StaznikSystems/Rocket-Beacon/hardware/documentation/Schematic.pdf

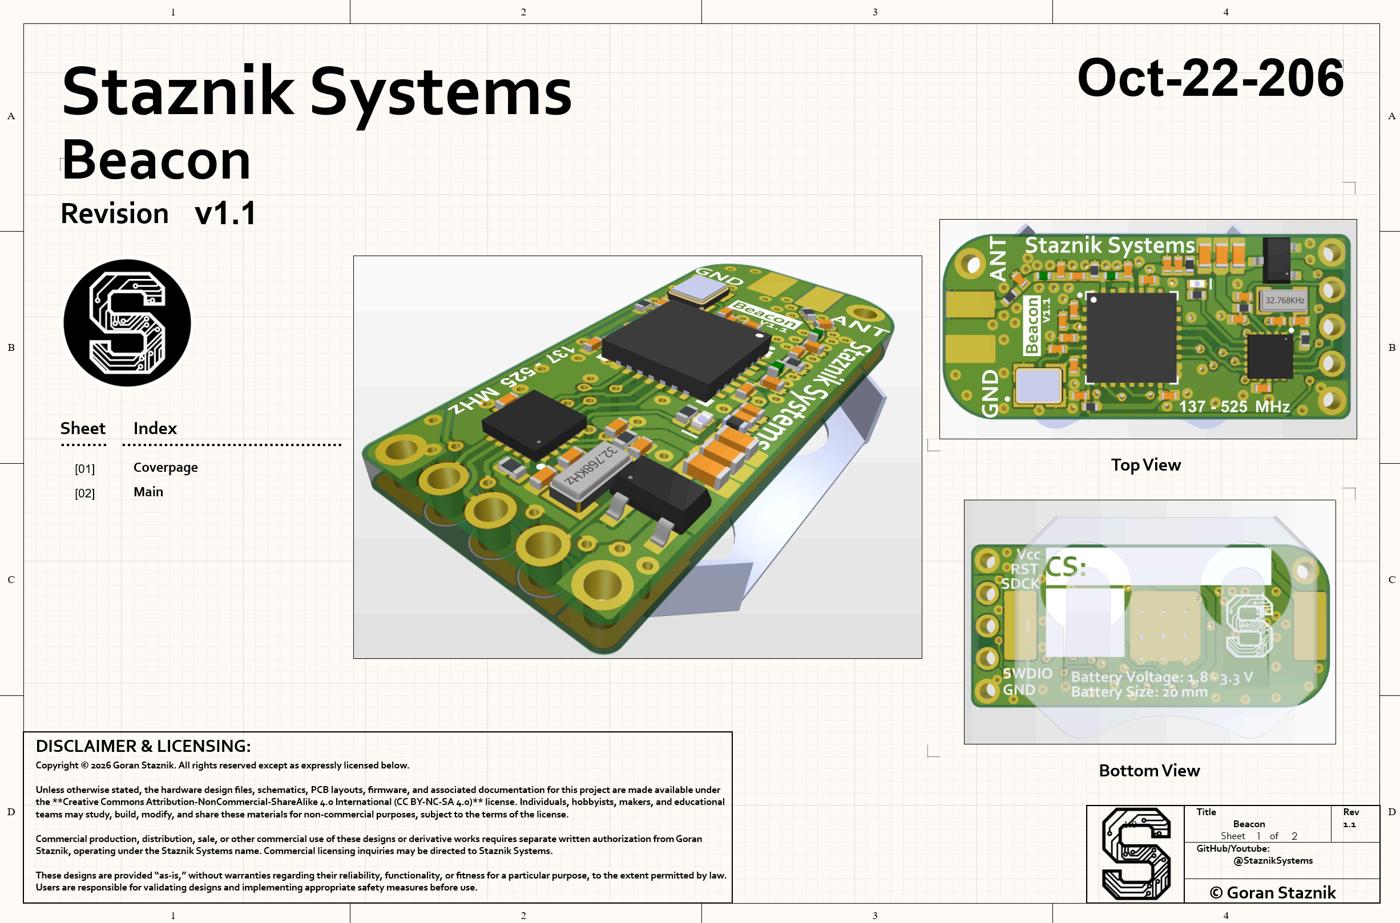
[picture p4: page 1]
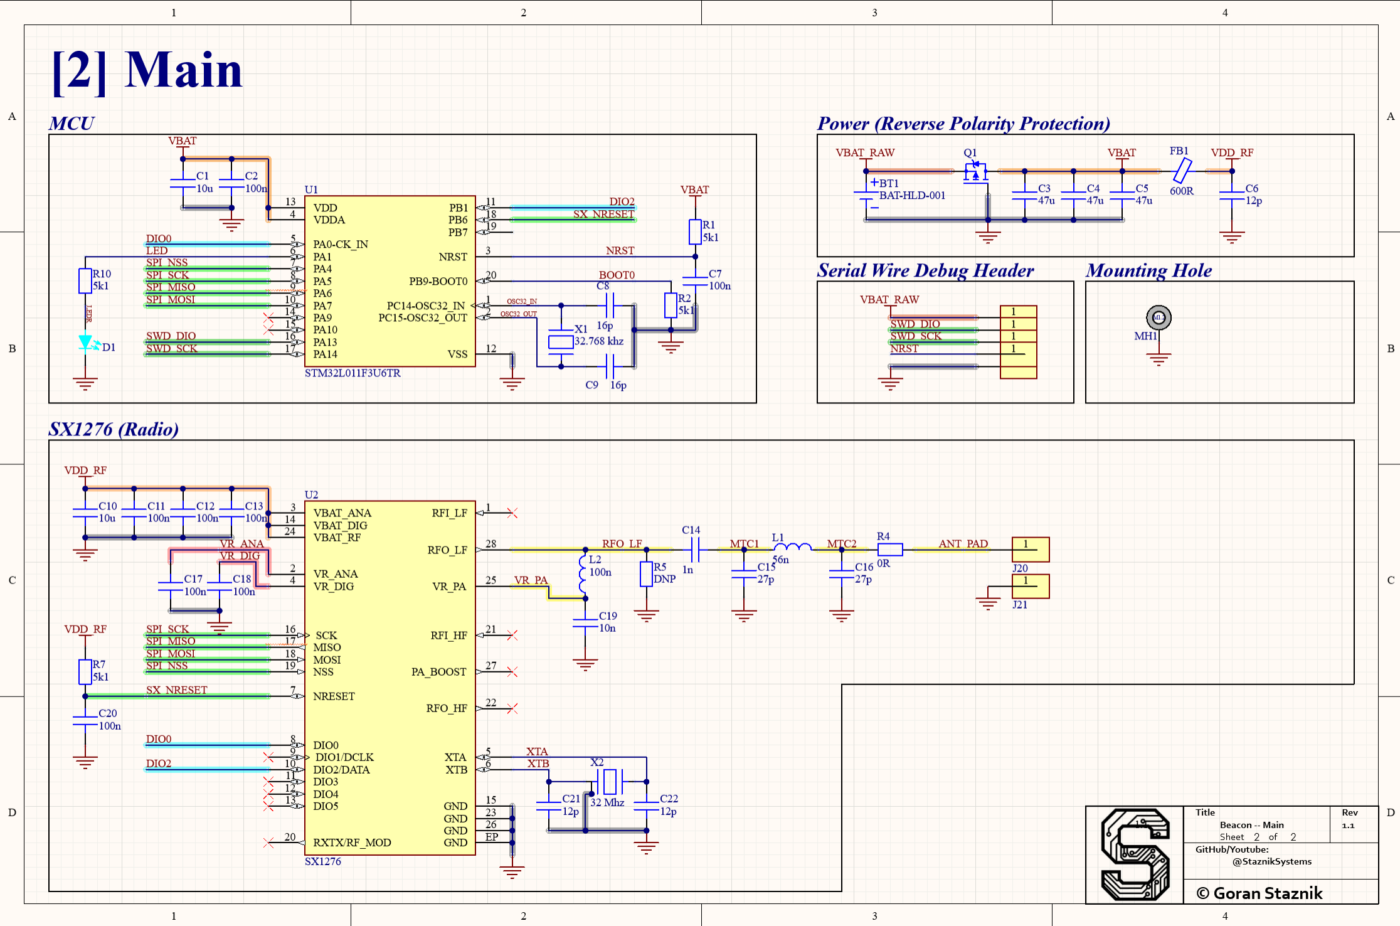
[picture p5: page 2]
