StaznikSystems/Rocket-Beacon/hardware/BOM/BOM.xlsx

Notes | Designator | Name | Description | Package | Status | Quantity | Manufacturer | Manufacturer Part Number | Supplier | Supplier Part Number | Supplier Unit Price (CAD) | Subtotal (CAD)
DNP | BT1 | BAT-HLD-001 | Battery Retainer Coin, 20.0mm 1 Cell SMD (SMT) Tab | NS | Active | 1 | TE Connectivity | BAT-HLD-001 | Digikey | BAT-HLD-001-ND | $0.3800 | $0.3800
Populate | C1, C10 | 10u | 0402 Capacitor | 0402 | Not Sourced | 2
Populate | C2, C7, C11, C12, C13, C17, C18, C20, | 100n | 0402 Capacitor | 0402 | Not Sourced | 8
Populate | C3, C4, C5 | 47u | 0603 Capacitor | 0603 | Not Sourced | 3
Populate | C6, C21, C22 | 12p | 0402 Capacitor | 0402 | Not Sourced | 3
Populate | C8, C9 | 16p | 0402 Capacitor | 0402 | Not Sourced | 2
Populate | C14 | 1n | 0402 Capacitor | 0402 | Not Sourced | 1
Populate | C15, C16 | 27p | 0402 Capacitor | 0402 | Not Sourced | 2 | Murata | GJM1555C1H270FB01J | Digikey |  | $0.0709 | $0.1418
Populate | C19 | 10n | 0402 Capacitor | 0402 | Not Sourced | 1
Populate | D1 | LED_0402_B | 0402 Blue LED | 0402 | Not Sourced | 1
Populate | FB1 | 600R | 0402 Ferrite Bead | 0402 | Not Sourced | 1 | Murata | BLM15AX601SN1D | Digikey |  | $0.0139 | $0.0139
Populate | L1 | 56n | 0402 Inductor | 0402 | Not Sourced | 1 | Murata | LQW15AN56NH00D | Digikey |  | $1.0200 | $1.0200
Populate | L2 | 100n | 0402 Inductor | 0402 | Not Sourced | 1 | Murata | LQW18ANR10G80D | Digikey |  | $0.1221 | $0.1221
Populate | Q1 | P-TYPE_SOT23 | SOT23 P-TYPE MOSFET | SOT23 | Active | 1 | Alpha & Omega Semiconductor | AO3401A | Digikey | 785-1001-2-ND | $0.5200 | $0.5200
DNP | MH1
DNP | J21,J2,J20,J3,J4,J5,J6
Populate | R1, R2, R7, R10 | 5k1 | 0402 Resistor | 0402 | Active | 4 | Yageo Group | AC0402FR-7W5K1L | Digikey |  | $0.0077 | $0.0308
Populate | R4 | 0R | 0402 Resistor | 0402 | Not Sourced | 1
DNP | R5 | DNP | 0402 Resistor | 0402 | DNP | 1
Populate | U1 | STM32L011F3U6TR | ARM Cortex-M0+ STM32L0 Microcontroller IC 32-Bit 32MHz 8KB (8K x 8) FLASH 20-UFQFPN (3x3) | UFQFPN-20 | Active | 1 | STMicroelectronics | STM32L011F3U6TR | Digikey |  | $7.3000 | $7.3000
Populate | U2 | SX1276 | IC RF TxRx Only 802.15.4 LoRa 137MHz ~ 1.02GHz 28-VQFN Exposed Pad | VQFN-28 | Active | 1 | Semtech | SX1276IMLTRT | Digikey |  | $11.4400 | $11.4400
Populate | X1 | 32.768 kHz | 32.768kHz Crystal, 12.5 pF Load | NS | Active | 1 | Jauch | Q 0,032768-JTX310-12,5-20-T2-70K-LF | Digikey |  | $0.2700 | $0.2700
Populate | X2 | 32 MHz | 32 MHz Crystal, 8pF Load | NS | Active | 1 | Jauch | J32SMX-K-F-D-I-32M0 | Digikey |  | $0.3000 | $0.3000
 |  |  |  |  |  |  |  |  |  |  | Total | $21.5386
