StaznikSystems/Rocket-Beacon/hardware/3dModel/Beacon.step

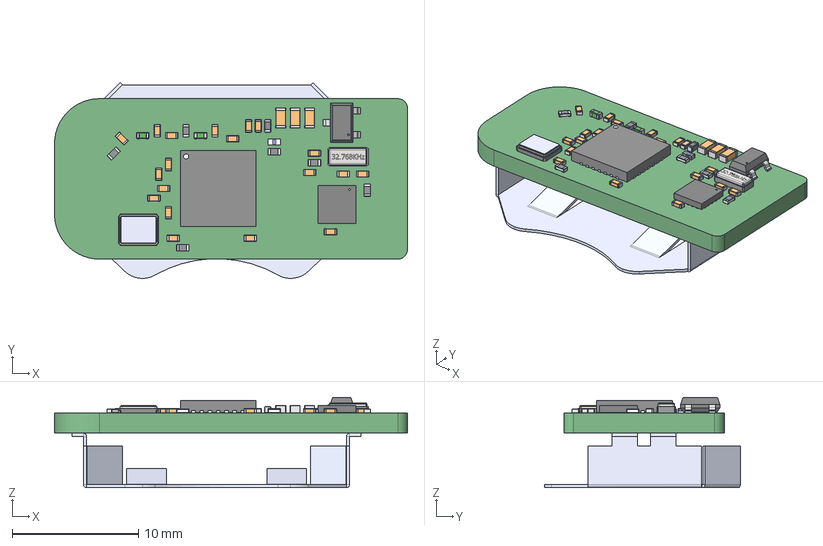
[picture p6: CAD file, 2026-10-23]
hardware/3dModel/Beacon.step
27.9 x 15.5 x 7.16 mm
R0402 AC0402 x 24
0402 Blue x 6
NX3225SA-32MHZ-EXS00A-CS02368
Crystal_3215
Pin1 x 2
Pin2 x 2
CeramicBody x 2
ferrite_bead_0402
C0402_035 x 57
C0603_060 x 9
BAT-HLD-001
