StaznikSystems/Rocket-Beacon/hardware/documentation/BeaconAssemDoc.pdf

A

B

C

D

E

1 | 1

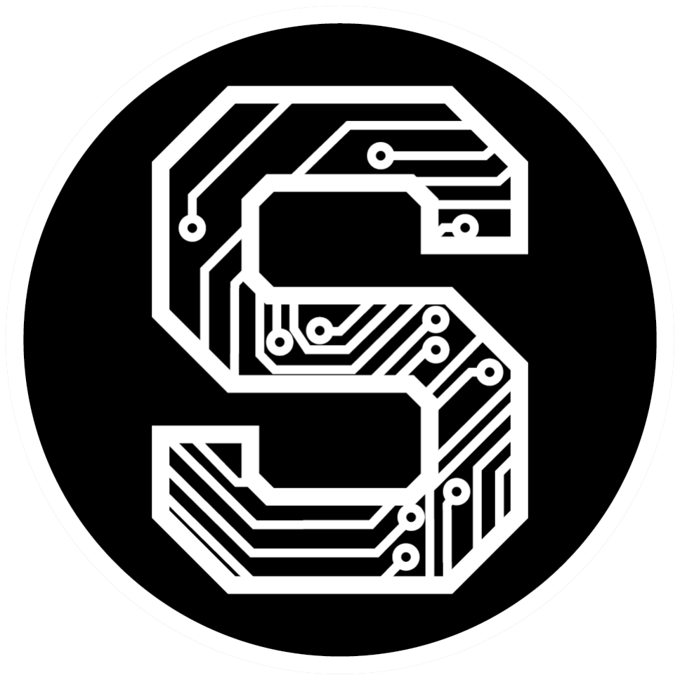
[picture p7: figure]

2 | 2

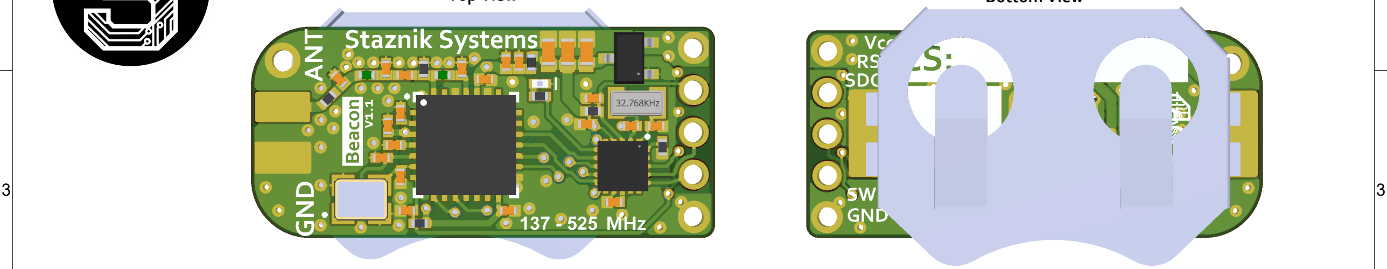
[picture p8: figure]
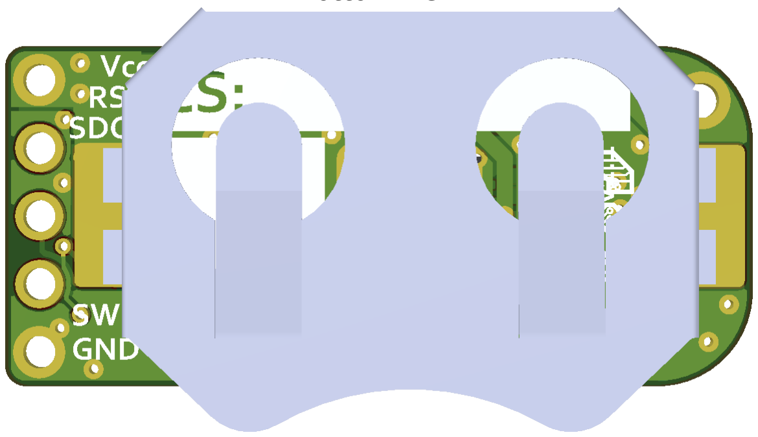
[picture p9: figure]

4 | 4

### Title Sheet 1 of 5

# © Goran Staznik

### Rev

### GitHub/YouTube: @StaznikSystems

Cover Page | 1.1

Copyright © Goran Staznik. All rights reserved except as expressly licensed below.

Unless otherwise stated, the hardware design files, schematics, PCB layouts, firmware, and associated documentation for this project are made available under the **Creative Commons Attribution-NonCommercial-ShareAlike 4.0 International (CC BY-NC-SA 4.0)** license. Individuals, hobbyists, makers, and educational teams may study, build, modify, and share these materials for non-commercial purposes, subject to the terms of the license.

Commercial production, distribution, sale, or other commercial use of these designs or derivative works requires separate written authorization from Goran Staznik, operating under the Staznik Systems name. Commercial licensing inquiries may be directed to Staznik Systems.

These designs are provided “as-is,” without warranties regarding their reliability, functionality, or fitness for a particular purpose, to the extent permitted by law. Users are responsible for validating designs and implementing appropriate safety measures before use.

# DISCLAIMER & LICENSING

# Beacon

# Staznik Systems

# Revision

# Assembly Documentation

Top View | Bottom View

v1.1

1 | 1

# [2] Isometric Views

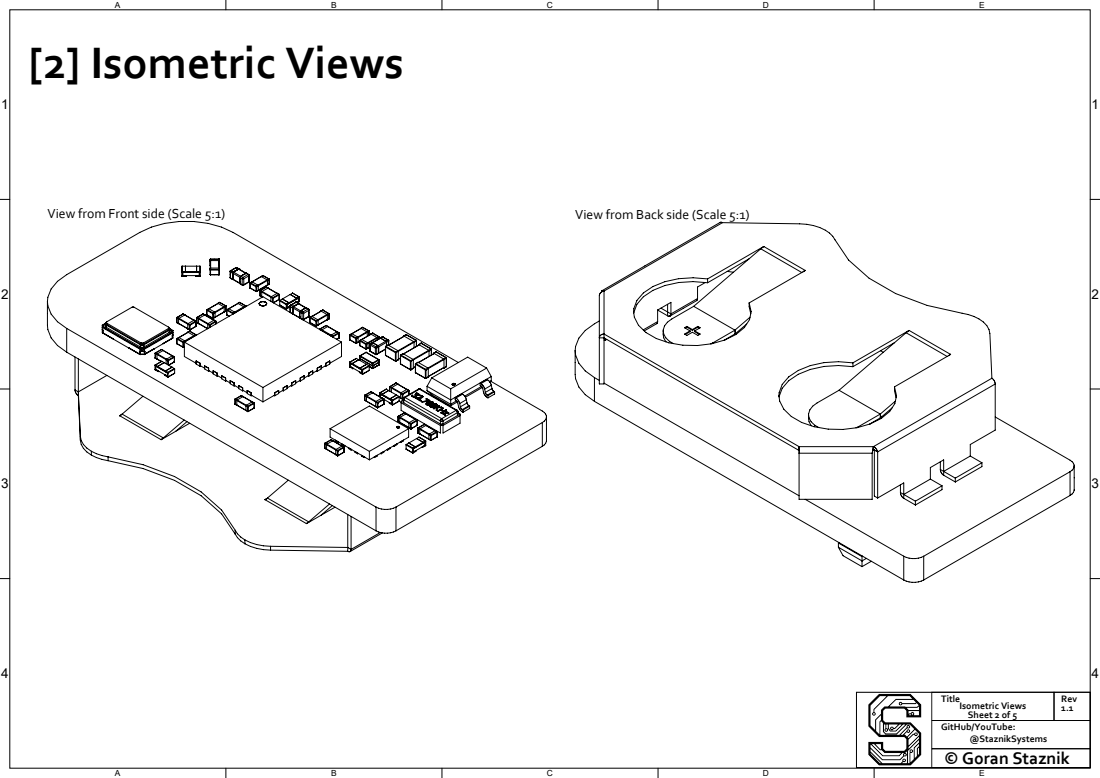
[picture p10: page 2]
View from Front side (Scale 5:1); View from Back side (Scale 5:1); Title; Sheet 2 of 5; Rev; Isometric Views

1 | 1

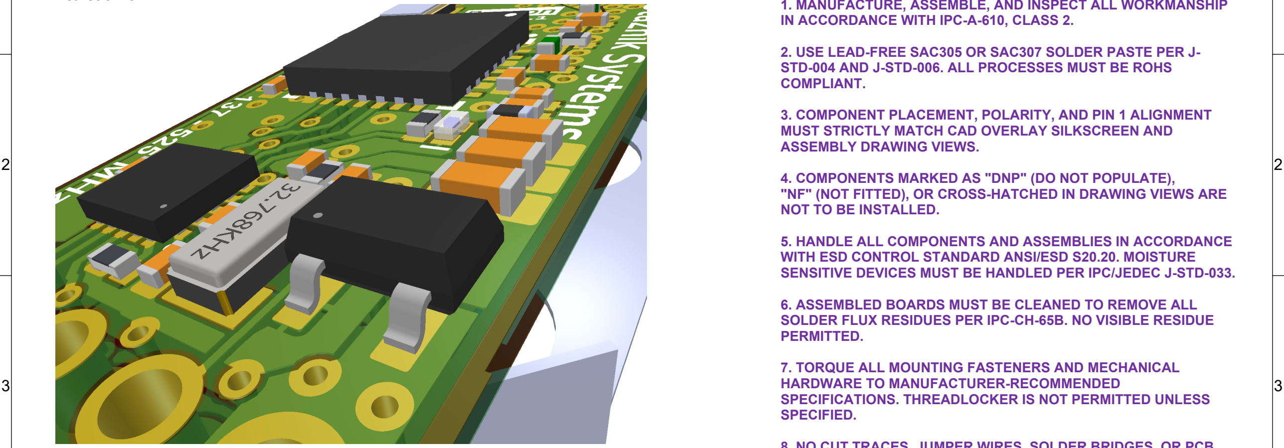
[picture p11: figure]
IN ACCORDANCE WITH IPC-A-610, CLASS 2.; COMPLIANT.; ASSEMBLY DRAWING VIEWS.; NOT TO BE INSTALLED.; PERMITTED.; HARDWARE TO MANUFACTURER-RECOMMENDED; SPECIFIED.

4 | 4

# [3] Notes

NOTES: UNLESS OTHERWISE SPECIFIED.

## 1. MANUFACTURE, ASSEMBLE, AND INSPECT ALL WORKMANSHIP

## 2. USE LEAD-FREE SAC305 OR SAC307 SOLDER PASTE PER J-STD-004 AND J-STD-006. ALL PROCESSES MUST BE ROHS

## 3. COMPONENT PLACEMENT, POLARITY, AND PIN 1 ALIGNMENT MUST STRICTLY MATCH CAD OVERLAY SILKSCREEN AND

4. COMPONENTS MARKED AS "DNP" (DO NOT POPULATE),

## "NF" (NOT FITTED), OR CROSS-HATCHED IN DRAWING VIEWS ARE

## 5. HANDLE ALL COMPONENTS AND ASSEMBLIES IN ACCORDANCE WITH ESD CONTROL STANDARD ANSI/ESD S20.20. MOISTURE

SENSITIVE DEVICES MUST BE HANDLED PER IPC/JEDEC J-STD-033.

## 6. ASSEMBLED BOARDS MUST BE CLEANED TO REMOVE ALL SOLDER FLUX RESIDUES PER IPC-CH-65B. NO VISIBLE RESIDUE

## 7. TORQUE ALL MOUNTING FASTENERS AND MECHANICAL

## SPECIFICATIONS. THREADLOCKER IS NOT PERMITTED UNLESS

## 8. NO CUT TRACES, JUMPER WIRES, SOLDER BRIDGES, OR PCB MODIFICATIONS ARE PERMITTED WITHOUT PRIOR WRITTEN

AUTHORIZATION.

# Realistic View

### Title Sheet 3 of 5

### Rev

Notes | 1.1

1 | 1

# View from Top side (Scale 8:1)

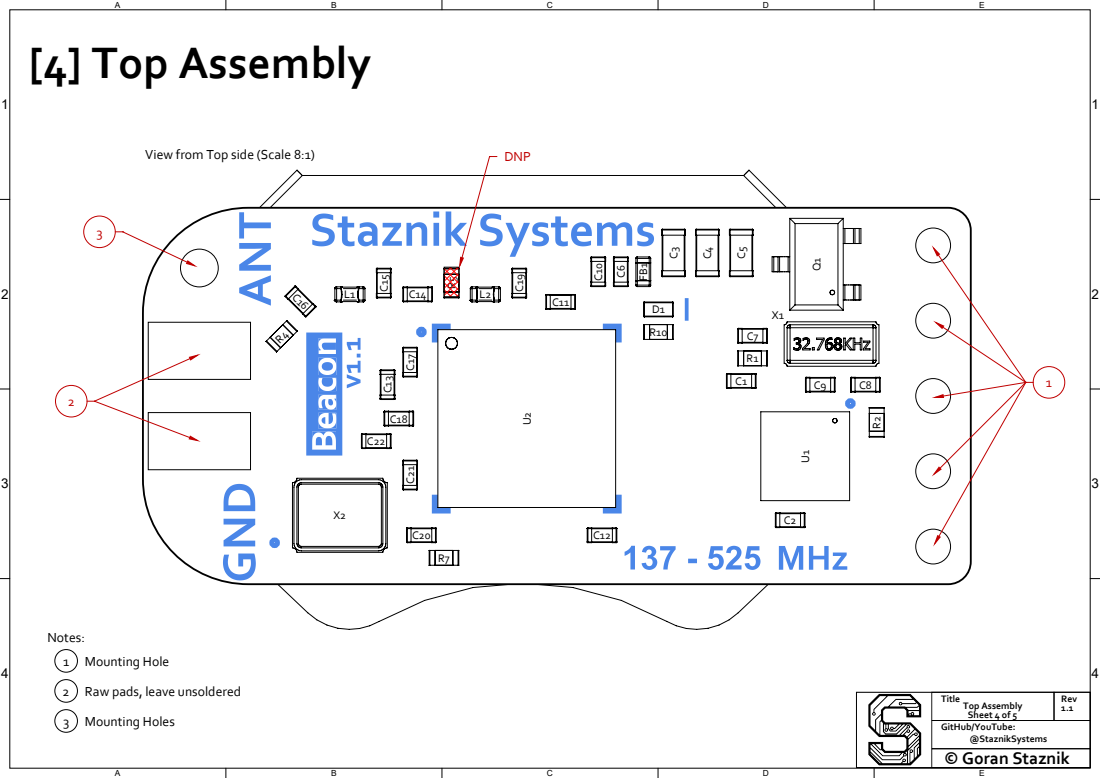
[picture p12: page 4]

Notes:
1 Mounting Hole
2 Raw pads, leave unsoldered
3 Mounting Holes

1 | 1

# View from Bottom side (Scale 8:1)

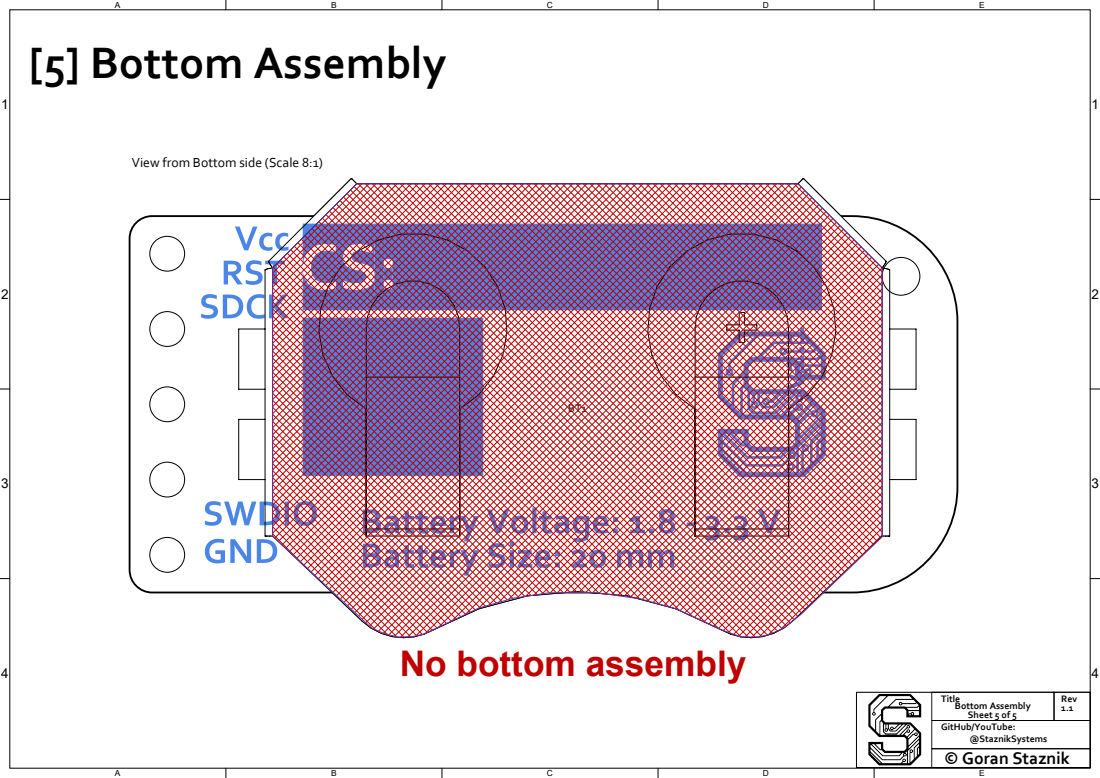
[picture p13: page 5]
[5] Bottom Assembly; Title; Sheet 5 of 5; Rev; Bottom Assembly

No bottom assembly
