StaznikSystems/Rocket-Beacon/hardware/documentation/BeaconFabDoc.pdf

A

B

C

D

E

1 | 1

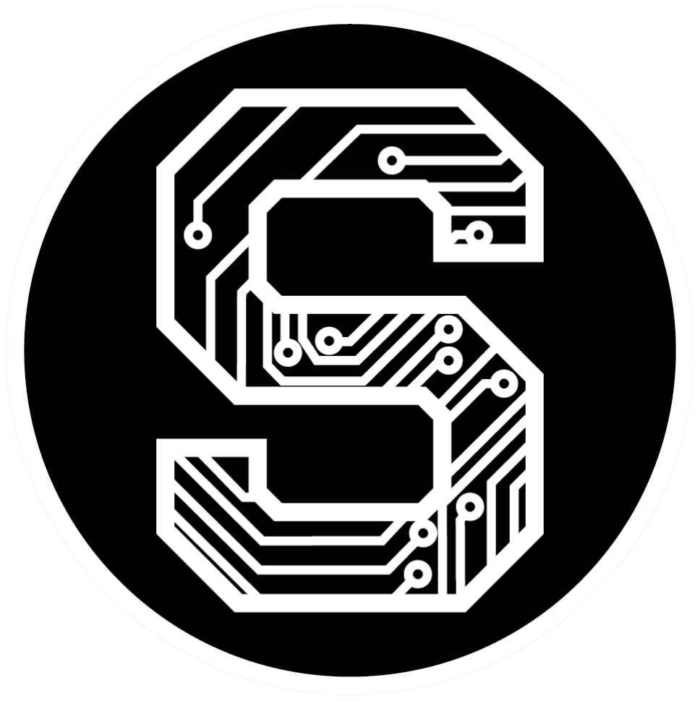
[picture p14: figure]

2 | 2

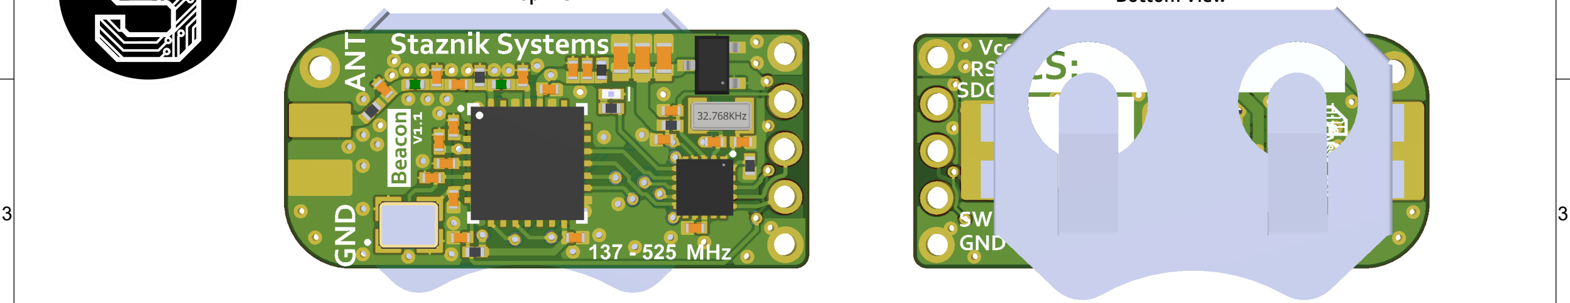
[picture p15: figure]
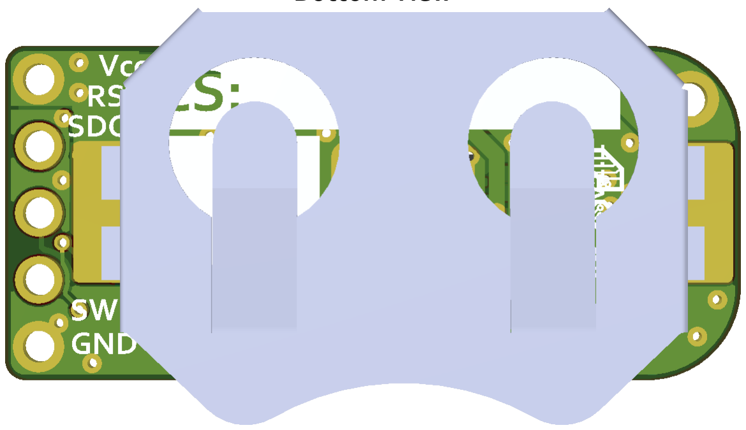
[picture p16: figure]

4 | 4

# Beacon

# Staznik Systems

# Revision

# PCB Fabrication Documentation

Title
Sheet 1 of 4
Top View | Bottom View

## © Goran Staznik

Rev

GitHub/YouTube:
@StaznikSystems

Copyright © Goran Staznik. All rights reserved except as expressly licensed below.

Unless otherwise stated, the hardware design files, schematics, PCB layouts, firmware, and associated documentation for this project are made available under the **Creative Commons Attribution-NonCommercial-ShareAlike 4.0 International (CC BY-NC-SA 4.0)** license. Individuals, hobbyists, makers, and educational teams may study, build, modify, and share these materials for non-commercial purposes, subject to the terms of the license.

Commercial production, distribution, sale, or other commercial use of these designs or derivative works requires separate written authorization from Goran Staznik, operating under the Staznik Systems name. Commercial licensing inquiries may be directed to Staznik Systems.

These designs are provided “as-is,” without warranties regarding their reliability, functionality, or fitness for a particular purpose, to the extent permitted by law. Users are responsible for validating designs and implementing appropriate safety measures before use.

## DISCLAIMER & LICENSING

v1.1

Cover Page | 1.1

# [2] Stack up & Impedance Information

Material | Layer | Thickness Dielectric Material Type | Gerber

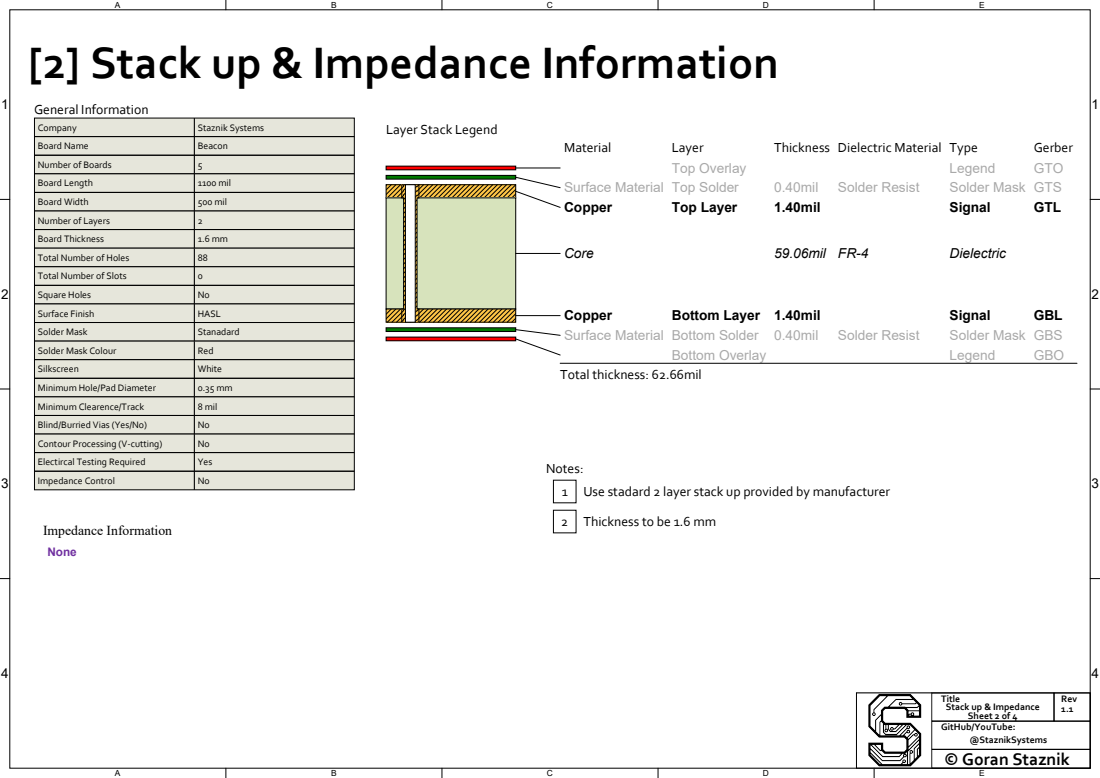
[picture p17: page 2]
Top Overlay; Legend; GTO; Surface Material Top Solder; 0.40mil; Solder Resist; Solder Mask GTS; Copper; Top Layer; 1.40mil; Signal; GTL; Core; 59.06mil FR-4; Dielectric; Bottom Layer 1.40mil; GBL; Surface Material Bottom Solder 0.40mil; Solder Mask GBS; Bottom Overlay; GBO; Total thickness: 62.66mil; Company; Layer Stack Legend; Staznik Systems; Beacon; 1100 mil; 500 mil; HASL; Stanadard; Red; White; 8 mil; Yes; Impedance Information; None; Title; Sheet 2 of 4; Rev; Stack up & Impedance

General Information
Board Name
Number of Boards
Board Length
Board Width
Number of Layers
Board Thickness
Total Number of Holes
Total Number of Slots

Square Holes
Surface Finish
Solder Mask
Solder Mask Colour
Silkscreen
Minimum Hole/Pad Diameter
Minimum Clearence/Track
Blind/Burried Vias (Yes/No)
Contour Processing (V-cutting)
Electircal Testing Required
Impedance Control

Notes:
1 Use stadard 2 layer stack up provided by manufacturer
2 Thickness to be 1.6 mm

### Drill Drawing View (Scale 5:1)

# [3] Drill Drawing & Notes

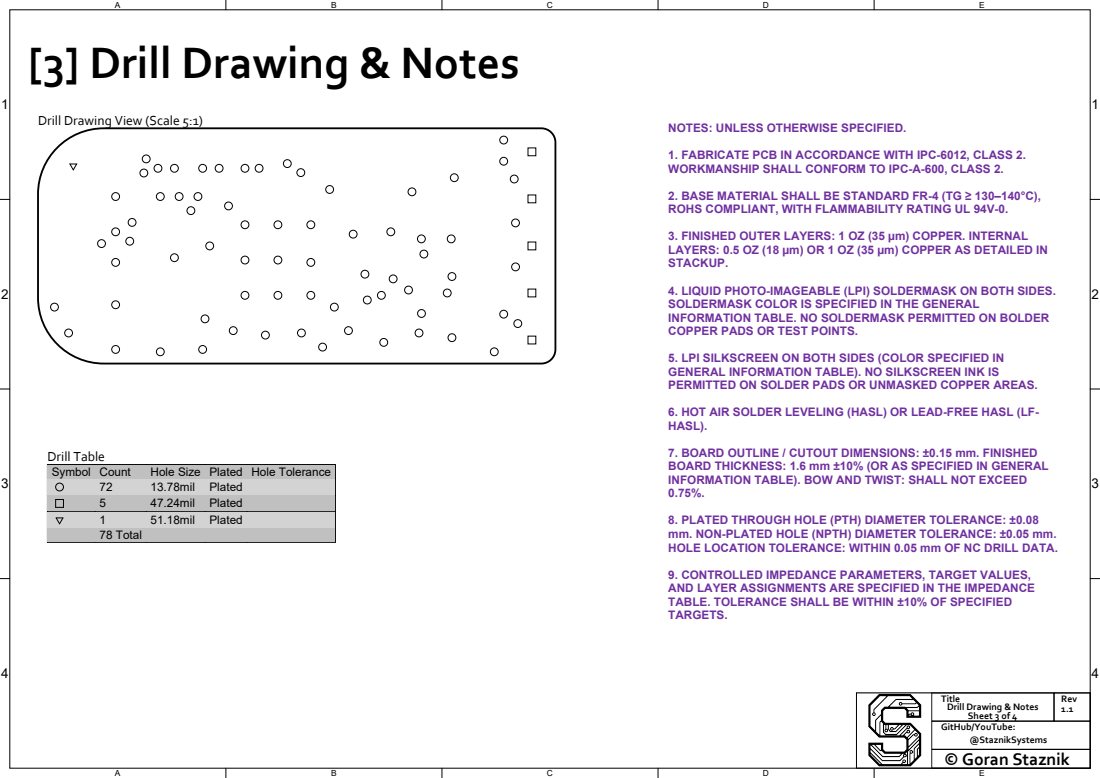
[picture p18: page 3]
Drill Table; Title; Sheet 3 of 4; Rev; Drill Drawing & Notes

NOTES: UNLESS OTHERWISE SPECIFIED.

1. FABRICATE PCB IN ACCORDANCE WITH IPC-6012, CLASS 2.
WORKMANSHIP SHALL CONFORM TO IPC-A-600, CLASS 2.

2. BASE MATERIAL SHALL BE STANDARD FR-4 (TG ≥ 130–140°C),
ROHS COMPLIANT, WITH FLAMMABILITY RATING UL 94V-0.

3. FINISHED OUTER LAYERS: 1 OZ (35 µm) COPPER. INTERNAL
LAYERS: 0.5 OZ (18 µm) OR 1 OZ (35 µm) COPPER AS DETAILED IN
STACKUP.

4. LIQUID PHOTO-IMAGEABLE (LPI) SOLDERMASK ON BOTH SIDES.
SOLDERMASK COLOR IS SPECIFIED IN THE GENERAL
INFORMATION TABLE. NO SOLDERMASK PERMITTED ON BOLDER
COPPER PADS OR TEST POINTS.

5. LPI SILKSCREEN ON BOTH SIDES (COLOR SPECIFIED IN
GENERAL INFORMATION TABLE). NO SILKSCREEN INK IS
PERMITTED ON SOLDER PADS OR UNMASKED COPPER AREAS.

6. HOT AIR SOLDER LEVELING (HASL) OR LEAD-FREE HASL (LF-
HASL).

7. BOARD OUTLINE / CUTOUT DIMENSIONS: ±0.15 mm. FINISHED
BOARD THICKNESS: 1.6 mm ±10% (OR AS SPECIFIED IN GENERAL
INFORMATION TABLE). BOW AND TWIST: SHALL NOT EXCEED

Symbol | Count | Hole Size | Plated | Hole Tolerance

72 | 13.78mil | Plated
5 | 47.24mil | Plated
1 | 51.18mil | Plated
78 Total

8. PLATED THROUGH HOLE (PTH) DIAMETER TOLERANCE: ±0.08
mm. NON-PLATED HOLE (NPTH) DIAMETER TOLERANCE: ±0.05 mm.
HOLE LOCATION TOLERANCE: WITHIN 0.05 mm OF NC DRILL DATA.

9. CONTROLLED IMPEDANCE PARAMETERS, TARGET VALUES,
AND LAYER ASSIGNMENTS ARE SPECIFIED IN THE IMPEDANCE
TABLE. TOLERANCE SHALL BE WITHIN ±10% OF SPECIFIED
TARGETS.

### Top Layer (Scale 5:1)

# [4] Layer Views

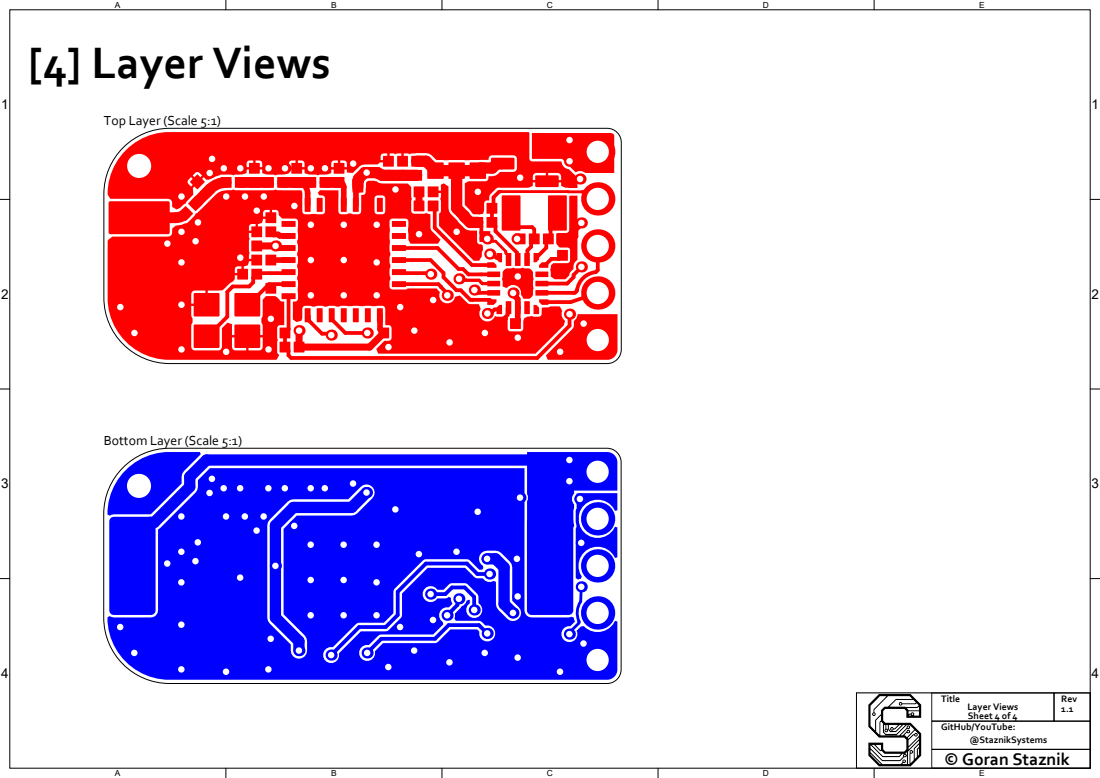
[picture p19: page 4]
Title; Sheet 4 of 4; Rev; Layer Views

Bottom Layer (Scale 5:1)
